techguy10k/educational-board/40-主控板/主控板背面.jpg

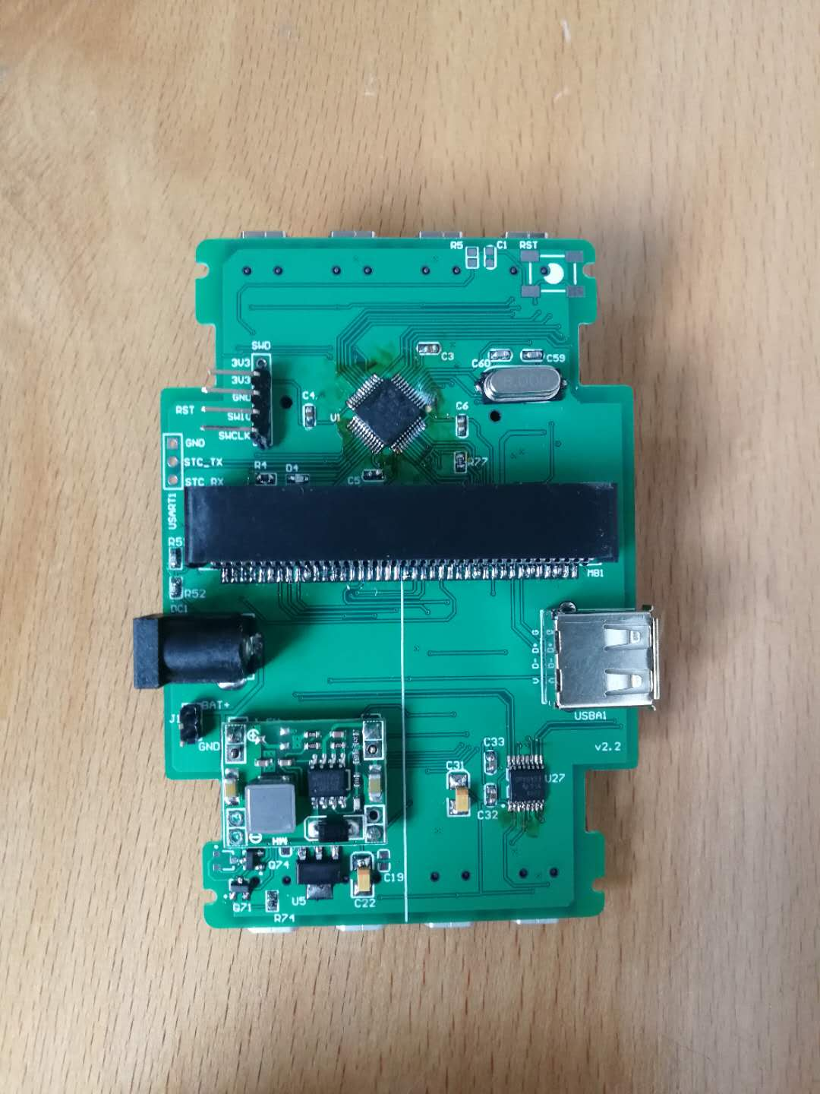
40-主控板/主控板背面.jpg
