techguy10k/educational-board/40-主控板/主控板正面.jpg

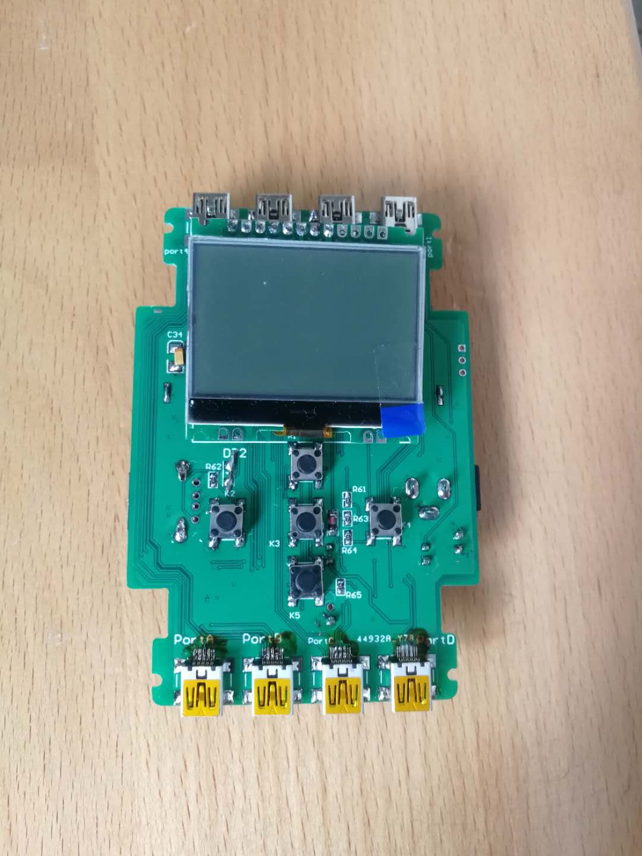
40-主控板/主控板正面.jpg
