techguy10k/educational-board/30-电机/电机参数图纸.docx

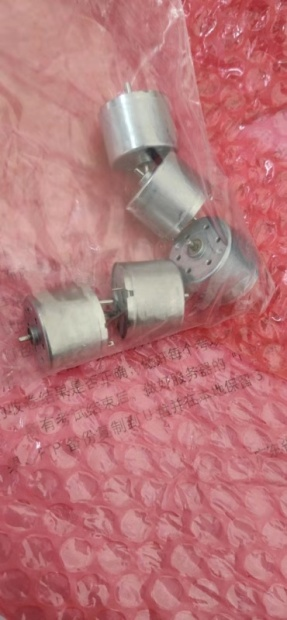
[picture p9: figure]

东莞富泰电机厂，

联系人：叶工， 电话：13532329905

需提前5天联系定制。

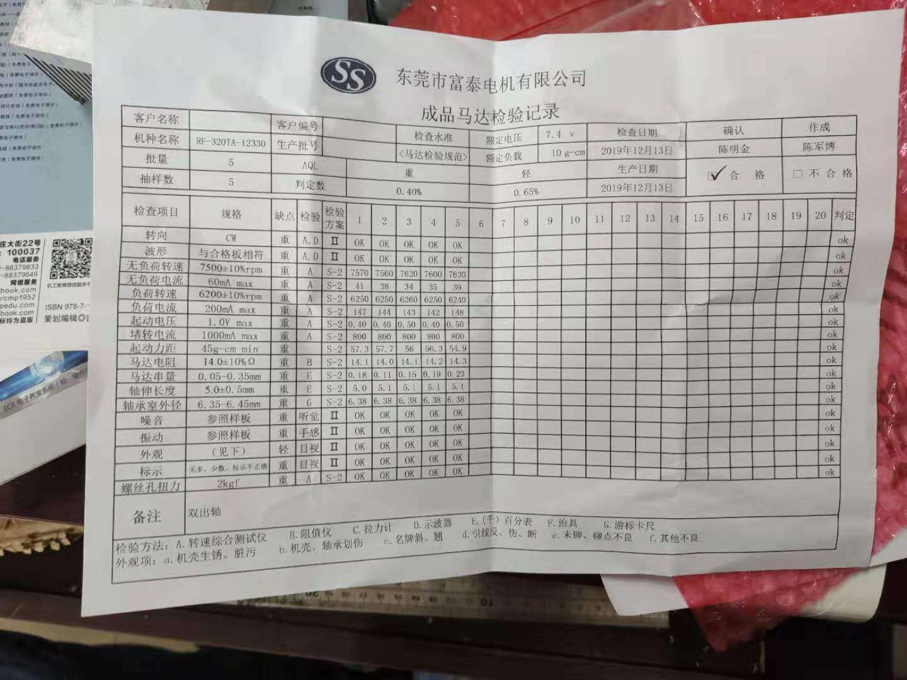
[picture p10: figure]
