techguy10k/educational-board/31-电机小板（霍尔编码器）/电机小板上的元件说明.docx

采购来源：

元件名称 | 数量 | 图片 | 网址

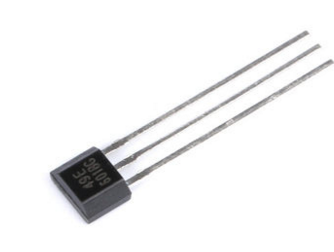
[picture p11: figure]

磁性传感器 41F | 2 | | yourcee旗舰店 (https://yourcee.tmall.com/) https://detail.tmall.com/item.htm?id=605320954363&spm=a1z09.2.0.0.72bd2e8dwAtcl9&_u=u3qeroq8b1d

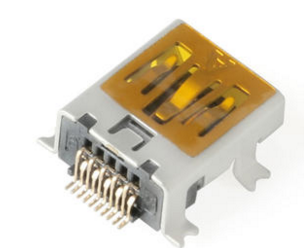
[picture p12: figure]

MiniUSB10P USB座 | 1 | | yourcee旗舰店 (https://yourcee.tmall.com/) https://detail.tmall.com/item.htm?id=599755569766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
订制的6芯USB软线 | 1 | | 需要与深圳一个线路厂联系订制

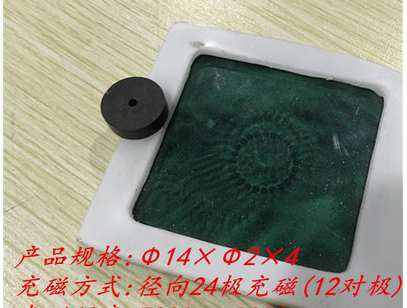
[picture p13: figure]

板外的元件一： 环形磁铁 | 1 | | 昊昶磁业 (https://suluke-magnet.taobao.com/) 网店 https://item.taobao.com/item.htm?spm=a1z09.2.0.0.72bd2e8dwAtcl9&id=542413343222&_u=u3qeroq0bea
板外的元件二： 小直流电机 | 1 | | 东莞富泰电机厂，需提前5天联系定制。

电机参数图：

见下页：
