techguy10k/educational-board/40-主控板/主控板上元件说明.docx

采购来源：

元件名称 | 数量 | 图片 | 网址

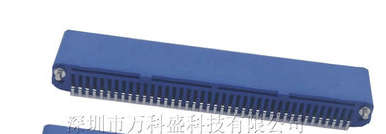
[picture p14: figure]

microbit卧式槽 | 1 | | (https://yourcee.tmall.com/)万科盛科技 (https://shop116882086.taobao.com/) 店 https://item.taobao.com/item.htm?spm=a1z09.2.0.0.626e2e8dIi6Jch&id=601872592752&_u=u3qeroqe064


MiniUSB10P USB座 （接4路电机） | 4 | | yourcee旗舰店 (https://yourcee.tmall.com/) https://detail.tmall.com/item.htm?id=599755569766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
订制的6芯USB软线 （接4路电机） | 4 | | 需要与深圳一个线路厂联系订制（蔡老师有联系方式）

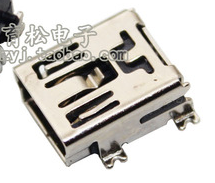
[picture p15: figure]

MINI USB 母座 插座 5P （接4路传感器模块） | 4 | | 育松电子经营部 (https://dzyj.taobao.com/)网店 https://item.taobao.com/item.htm?spm=a1z09.2.0.0.626e2e8dIi6Jch&id=1927829853&_u=u3qeroqed5f

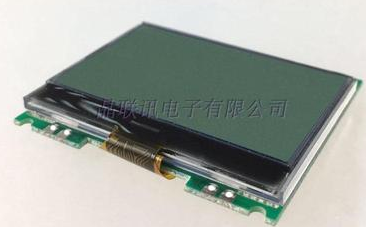
[picture p16: figure]

LCD屏 型号：12864G-086-PC | 1 | | 晶联讯电子 (https://jlxlcd.taobao.com/) https://item.taobao.com/item.htm?spm=a1z09.2.0.0.626e2e8dIi6Jch&id=12879087349&_u=u3qeroq2545

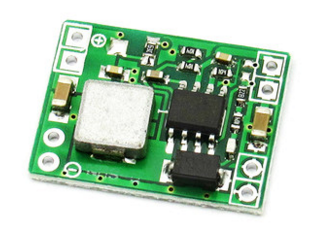
[picture p17: figure]

电源降压模块 （把锂电池电压降到5V，给板子供电） | 1 | | risym旗舰店 (https://risym.tmall.com/) https://detail.tmall.com/item.htm?id=17616429123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
