techguy10k/educational-board/01-超声波传感器模块/超声波传感器-尺寸结构.png

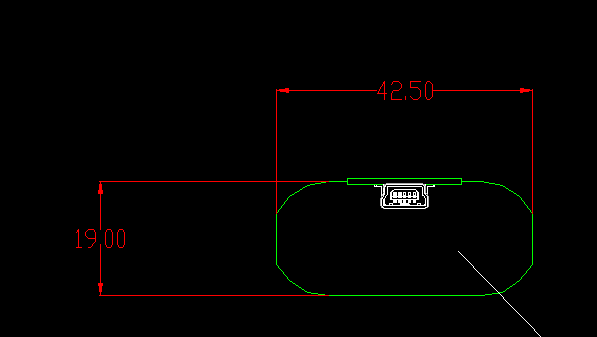
01-超声波传感器模块/超声波传感器-尺寸结构.png
