techguy10k/educational-board/02-碰撞模块/方形的传感器模块的尺寸结构.png

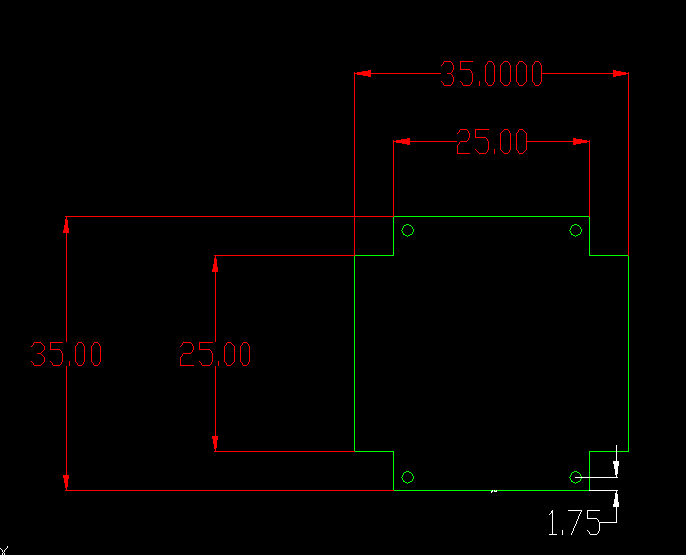
02-碰撞模块/方形的传感器模块的尺寸结构.png
