techguy10k/educational-board/12个传感器模块的列表.bmp

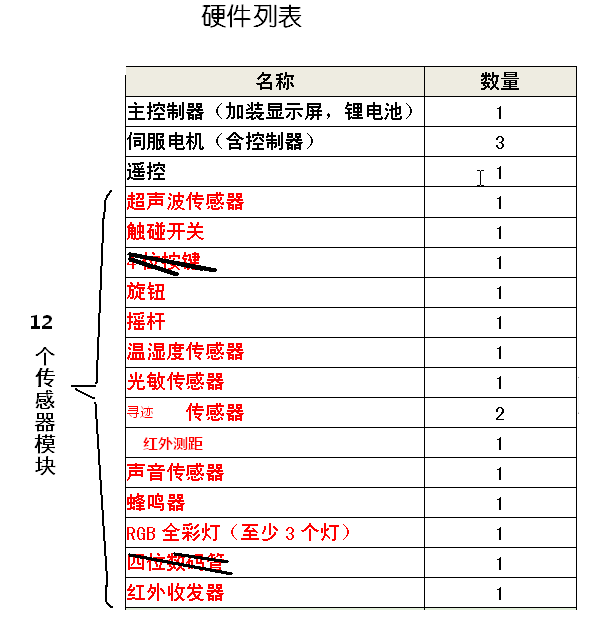
12个传感器模块的列表.bmp
