techguy10k/educational-board/01-超声波传感器模块/01-超声波传感器模块-尺寸结构图.dxf

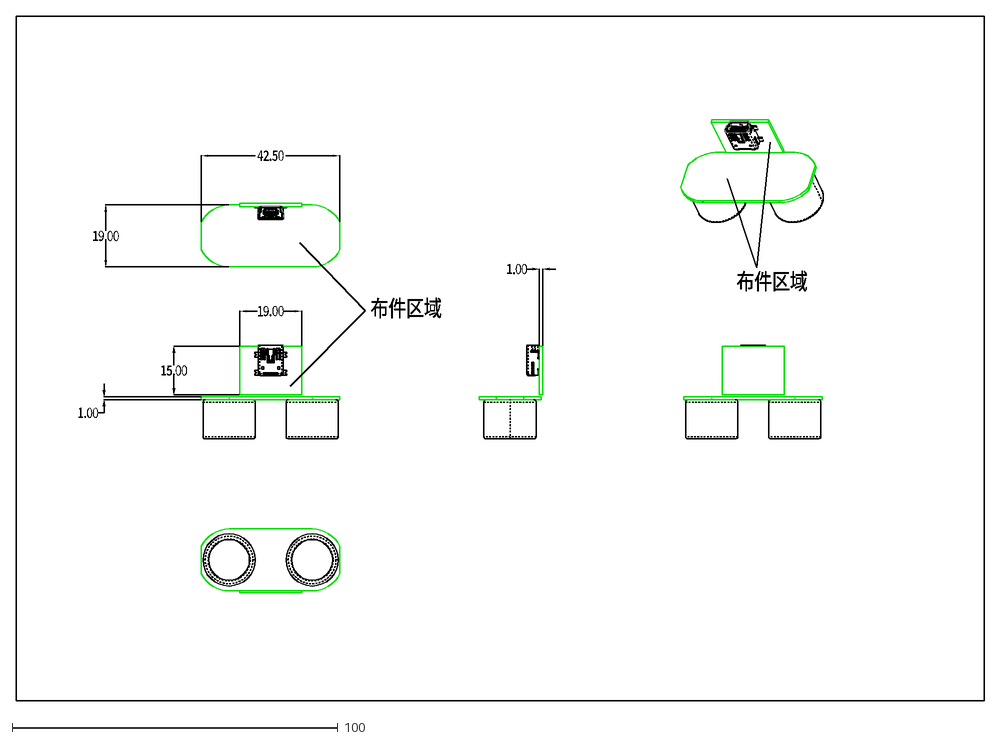
[picture p21: CAD file, 2020-11-19]
01-超声波传感器模块/01-超声波传感器模块-尺寸结构图.dxf
42.50
1.00
19.00
15.00
布件区域
