techguy10k/educational-board/02-碰撞模块/方形的传感器模块的尺寸结构图.dxf

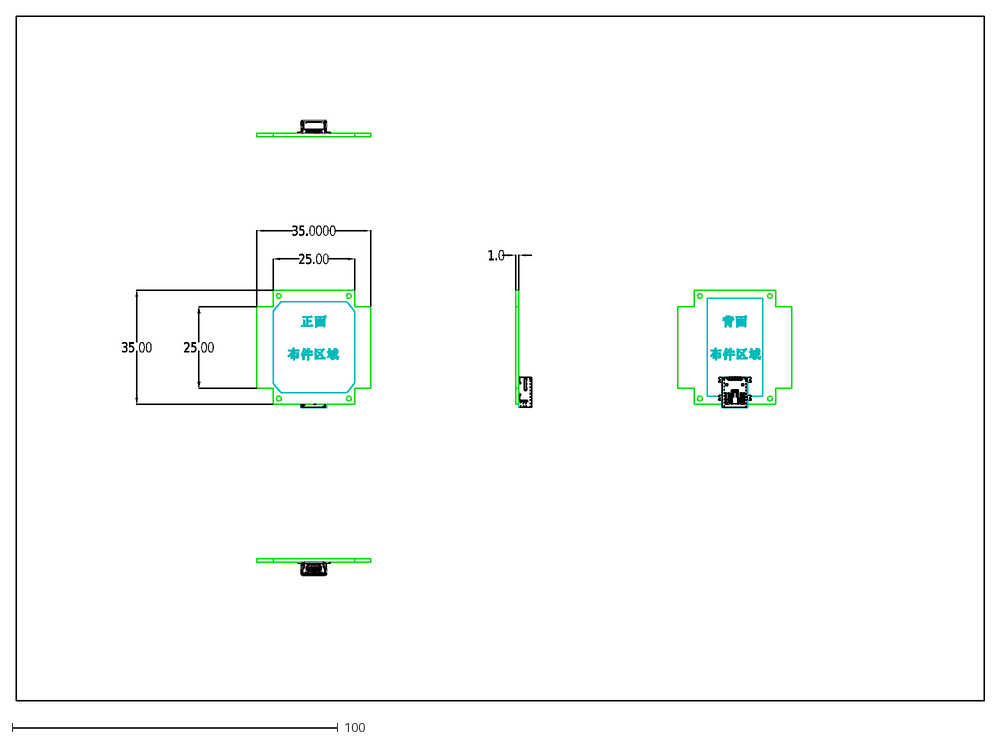
[picture p22: CAD file, 2020-11-19]
02-碰撞模块/方形的传感器模块的尺寸结构图.dxf
35.0000
25.00
35.00
1.0
