techguy10k/educational-board/31-电机小板（霍尔编码器）/电机小板的尺寸结构图.dxf

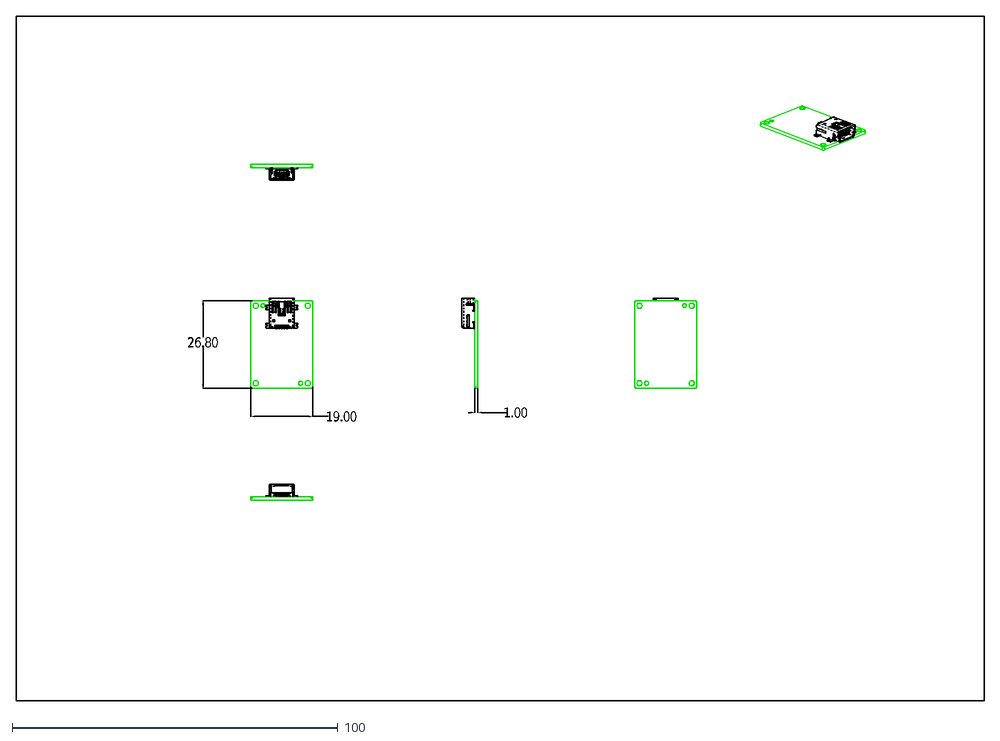
[picture p23: CAD file, 2020-11-19]
31-电机小板（霍尔编码器）/电机小板的尺寸结构图.dxf
26.80
19.00
1.00
