techguy10k/educational-board/(list of files, drawings)

Other design files:
01-超声波传感器模块/01-超声波传感器模块-原理图.SchDoc
01-超声波传感器模块/01-超声波传感器模块-电路板图.PcbDoc
02-碰撞模块/02-碰撞模块-原理图.SchDoc
02-碰撞模块/02-碰撞模块-电路板图.PcbDoc
03-旋钮模块/03-旋钮模块-原理图.SchDoc
04-摇杆模块/04-摇杆模块--原理图.SchDoc
05-温湿度传感器模块/05-温湿度传感器模块-原理图.SchDoc
05-温湿度传感器模块/05-温湿度传感器模块-电路板图.PcbDoc
06-光敏传感器模块/06-光敏传感器模块-原理图.SchDoc
06-光敏传感器模块/06-光敏传感器模块-电路板图.PcbDoc
07-寻迹传感器模块/07-寻迹传感器模块--原理图.SchDoc
08-声音传感器模块/08-声音传感器模块-原理图.SchDoc
08-声音传感器模块/08-声音传感器模块-电路板图.PcbDoc
09-蜂鸣器模块/09-蜂鸣器模块-原理图.SchDoc
10-RGB彩灯模块/10-RGB模块原理图.SchDoc
11-红外遥控接收器模块/11-红外遥控接收器模块--原理图.SchDoc
12-红外测距传感器模块/12-红外测距及避障原理图.SchDoc
31-电机小板（霍尔编码器）/电机小板的电路图.PcbDoc
31-电机小板（霍尔编码器）/电机小板（霍尔编码器）的原理图.SchDoc
40-主控板/40-主控板-电路图.PcbDoc
40-主控板/40-主控板的原理图.SchDoc
