techguy10k/educational-board/50-软件资料主控板/Project/HARDWARE/LCD12864/12864.c

#include "12864.h"
#include "sys.h"
#include "delay.h"

unsigned char biaoti[]={" HicBit "};

//用“zimo221.exe”取模出来的汉字的16进制码：
unsigned char zhuang1[]={
/*--  文字:  状  --*/
/*--  宋体12;  此字体下对应的点阵为：宽x高=16x16   --*/
0x08,0x30,0x00,0xFF,0x20,0x20,0x20,0x20,0xFF,0x20,0xE1,0x26,0x2C,0x20,0x20,0x00,
0x04,0x02,0x01,0xFF,0x40,0x20,0x18,0x07,0x00,0x00,0x03,0x0C,0x30,0x60,0x20,0x00};
 
unsigned char tai1[]={
/*--  文字:  态  --*/
/*--  宋体12;  此字体下对应的点阵为：宽x高=16x16   --*/
0x00,0x04,0x04,0x04,0x84,0x44,0x34,0x4F,0x94,0x24,0x44,0x84,0x84,0x04,0x00,0x00,
0x00,0x60,0x39,0x01,0x00,0x3C,0x40,0x42,0x4C,0x40,0x40,0x70,0x04,0x09,0x31,0x00};
 
unsigned char shi1[]={
/*--  文字:  使  --*/
/*--  宋体12;  此字体下对应的点阵为：宽x高=16x16   --*/
0x40,0x20,0xF0,0x1C,0x07,0xF2,0x94,0x94,0x94,0xFF,0x94,0x94,0x94,0xF4,0x04,0x00,
0x00,0x00,0x7F,0x00,0x40,0x41,0x22,0x14,0x0C,0x13,0x10,0x30,0x20,0x61,0x20,0x00};
 
unsigned char yong1[]={
/*--  文字:  用  --*/
/*--  宋体12;  此字体下对应的点阵为：宽x高=16x16   --*/
0x00,0x00,0x00,0xFE,0x22,0x22,0x22,0x22,0xFE,0x22,0x22,0x22,0x22,0xFE,0x00,0x00,
0x80,0x40,0x30,0x0F,0x02,0x02,0x02,0x02,0xFF,0x02,0x02,0x42,0x82,0x7F,0x00,0x00};
 
unsigned char dianchi1[]={
/*--  电池图标  --*/
/*--  宽度x高度=16x16  --*/
0x00,0x00,0x00,0x00,0x00,0x38,0x7C,0x44,0x7C,0x44,0x7C,0x44,0x7C,0x44,0x7C,0x00,
0x00,0x00,0x00,0x00,0x00,0x00,0x00,0x00,0x00,0x00,0x00,0x00,0x00,0x00,0x00,0x00};

unsigned char dianchi[]={
/*--  电池图标  --*/
/*--  宽度x高度=16x16  --*/
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
	
	GPIO_InitStructure.GPIO_Pin = cs_gpio|reset_gpio;				
	GPIO_InitStructure.GPIO_Mode = GPIO_Mode_Out_PP; 		 //推挽输出
	GPIO_InitStructure.GPIO_Speed = GPIO_Speed_50MHz;		 //IO口速度为50MHz
	GPIO_Init(GPIOA, &GPIO_InitStructure);					 //根据设定参数初始化GPIOA

}

//void main(void)
//{
//	int i;
//	UART_Init();
//	initial_lcd();
//	clear_screen();                        //clear all dots       
//	disp_blink_16x16(1,1,0,0,zhuang1);     //显示单个汉字"状". 括号里的参数分别是（页，列，闪烁与否，反显与否，数据指针）
//	disp_blink_16x16(1,17,0,0,tai1);        //显示单个汉字"态",不闪烁，反显
//	disp_blink_16x16(1,33,0,0,shi1);        //显示单个汉字"使",闪烁，不反显
//	disp_blink_16x16(1,49,0,0,yong1);       //显示单个汉字"用",闪烁，反显（当有闪烁时，反显不起作用）
//	disp_blink_16x16(1,113,0,0,dianchi);
//	LCD12864_P8x16Str(7,1,"123456789");
//	LCD12864_P6x8Str(6,1,"123456789");
//    while(1)
//    {
//		Uart_Send_String("Hello world!\r\n");
//		for(i=1;i<72;i++){
//			LCD12864_P6x8Str(6,i,"123456789");
//			delay_ms(100);
//		}
//		Uart_Send_String("www.ppptalk.com!!!\r\n");
//		Uart_Send_String("欢迎访问叁议电子!!!\r\n");
//    }
//}

 
/*写指令到LCD模块*/
void transfer_command(int data1)  
{
    char i;
    cs1=0;
    rs=0;
    for(i=0;i<8;i++)
    {
        sclk=0;
        if(data1&0x80) sid=1;
        else sid=0;
        sclk=1;
        data1<<=1;
    }
    cs1=1;
}
 
/*写数据到LCD模块*/
void transfer_data(int data1)
{
    char i;
    cs1=0;
    rs=1;
    for(i=0;i<8;i++)
    {
        sclk=0;
        if(data1&0x80) sid=1;
        else sid=0;
        sclk=1;
        data1<<=1;
    }
    cs1=1;
}
 
 
/*LCD模块初始化*/
void initial_lcd(void)
{
	LCD12864_Init();
    cs1=0;
    reset=0;        /*低电平复位*/	
    delay_us(500);
    reset=1;            /*复位完毕*/
    delay_us(200);       
    transfer_command(0xe2);  /*软复位*/
    delay_us(50);
    transfer_command(0x2c);  /*升压步聚1*/
    delay_us(50); 
    transfer_command(0x2e);  /*升压步聚2*/
    delay_us(50);
    transfer_command(0x2f);  /*升压步聚3*/
    delay_us(50);
    transfer_command(0x23);  /*粗调对比度，可设置范围0x20～0x27*/
    transfer_command(0x81);  /*微调对比度*/
    transfer_command(0x28);  /*0x28,微调对比度的值，可设置范围0x00～0x3f*/
    transfer_command(0xa2);  /*1/9偏压比（bias）*/
    transfer_command(0xc8);  /*行扫描顺序：从上到下*/
    transfer_command(0xa0);  /*列扫描顺序：从左到右*/
    transfer_command(0x40);  /*起始行：第一行开始*/
    transfer_command(0xaf);  /*开显示*/
}
 
 
void lcd_address(unsigned char page,unsigned char column)
{
    column=column-1;                            //我们平常所说的第1列，在LCD驱动IC里是第0列。所以在这里减去1.
    page=page-1;
    transfer_command(0xb0+page);            //设置页地址。每页是8行。一个画面的64行被分成8个页。我们平常所说的第1页，在LCD驱动IC里是第0页，所以在这里减去1*/
    transfer_command(((column>>4)&0x0f)+0x10);    //设置列地址的高4位
    transfer_command(column&0x0f);              //设置列地址的低4位
}
 
/*全屏清屏*/
void clear_screen(void)
{
    unsigned char i,j;
    for(i=0;i<9;i++)
    {
        lcd_address(1+i,1);
        for(j=0;j<132;j++)
        {
            transfer_data(0x00);
        }
    }
}
 
 
 
 
//显示16x16点阵图像、汉字。
//括号里的参数分别是（页，列，闪烁与否，反显与否，数据指针）
void disp_blink_16x16(unsigned char page,unsigned char column,unsigned char blink,unsigned char reverse,unsigned char *dp)
{
    unsigned char i,j,k,*data_temp;
    if(blink==0)
    {
        data_temp=dp;
        for(j=0;j<2;j++)
        {
            lcd_address(page+j,column);
            for (i=0;i<16;i++)
            {  
                if(reverse==1)
                {
                    transfer_data(~*data_temp); /*写数据到LCD,每写完一个8位的数据后列地址自动加1*/
                }
                else
                {
                    transfer_data(*data_temp);      /*写数据到LCD,每写完一个8位的数据后列地址自动加1*/
                }
                data_temp++;
            }
        }
    }
 
    else
    {
        for(k=0;k<10;k++)
        {
            data_temp=dp;
            for(j=0;j<2;j++)
            {
                lcd_address(page+j,column);
                for (i=0;i<16;i++)
                {  
                    transfer_data(~*data_temp);     /*写数据到LCD,每写完一个8位的数据后列地址自动加1*/
                    data_temp++;
                }
            }
            delay_ms(2000);
            data_temp=dp;
            for(j=0;j<2;j++)
            {
                lcd_address(page+j,column);
                for (i=0;i<16;i++)
                {  
                    transfer_data(*data_temp);      /*写数据到LCD,每写完一个8位的数据后列地址自动加1*/
                    data_temp++;
                }
            }
            delay_ms(2000);
 
        }
    }
}
 
//显示16x16点阵图像、汉字。
//括号里的参数分别是（页，列，带下划线闪烁与否，反显与否，数据指针）
void disp_underline_16x16(unsigned char page,unsigned char column,unsigned char under,unsigned char reverse,unsigned char *dp)
{
    unsigned char i,j,k,*data_temp,data1;
    if(under==0)
    {
        data_temp=dp;
        for(j=0;j<2;j++)
        {
            lcd_address(page+j,column);
            for (i=0;i<16;i++)
            {  
                if(reverse==1)
                {
                    transfer_data(~*data_temp); /*写数据到LCD,每写完一个8位的数据后列地址自动加1*/
                }
                else
                {
                    transfer_data(*data_temp);      /*写数据到LCD,每写完一个8位的数据后列地址自动加1*/
                }
                data_temp++;
            }
        }
    }
 
    else
    {
        for(k=0;k<10;k++)
        {
            data_temp=dp;
     
            lcd_address(page,column);
            for (i=0;i<16;i++)
            {  
                transfer_data(*data_temp);      /*写数据到LCD,每写完一个8位的数据后列地址自动加1*/
                data_temp++;
            }
            lcd_address(page+1,column);
            for (i=0;i<16;i++)
            {  
                data1=*data_temp|0x80;
                transfer_data(data1);       /*写数据到LCD,每写完一个8位的数据后列地址自动加1*/
                data_temp++;
            }
            delay_ms(2000);
 
 
            data_temp=dp;
            for(j=0;j<2;j++)
            {
                lcd_address(page+j,column);
                for (i=0;i<16;i++)
                {  
                    transfer_data(*data_temp);      /*写数据到LCD,每写完一个8位的数据后列地址自动加1*/
                    data_temp++;
                }
            }
            delay_ms(2000);
 
        }
    }
}
//显示16x16点阵图像、汉字。
//括号里的参数分别是（页，列，带右竖线光标闪烁与否，反显与否，数据指针）
void disp_cursor_16x16(unsigned char page,unsigned char column,unsigned char cursor,unsigned char reverse,unsigned char *dp)
{
    unsigned char i,j,k,*data_temp;
    if(cursor==0)
    {
        data_temp=dp;
        for(j=0;j<2;j++)
        {
            lcd_address(page+j,column);
            for (i=0;i<16;i++)
            {  
                if(reverse==1)
                {
                    transfer_data(~*data_temp); /*写数据到LCD,每写完一个8位的数据后列地址自动加1*/
                }
                else
                {
                    transfer_data(*data_temp);      /*写数据到LCD,每写完一个8位的数据后列地址自动加1*/
                }
                data_temp++;
            }
        }
    }
 
    else
    {
        for(k=0;k<10;k++)
        {
            data_temp=dp;
     
            lcd_address(page,column);
            for (i=0;i<15;i++)
            {  
                transfer_data(*data_temp);      /*写数据到LCD,每写完一个8位的数据后列地址自动加1*/
                data_temp++;
            }
            transfer_data(0xff);
            data_temp++;
            lcd_address(page+1,column);
            for (i=0;i<15;i++)
            {  
                transfer_data(*data_temp);      /*写数据到LCD,每写完一个8位的数据后列地址自动加1*/
                data_temp++;
            }
            transfer_data(0xff);
            data_temp++;
            delay_ms(2000);
 
 
            data_temp=dp;
            for(j=0;j<2;j++)
            {
                lcd_address(page+j,column);
                for (i=0;i<16;i++)
                {  
                    transfer_data(*data_temp);      /*写数据到LCD,每写完一个8位的数据后列地址自动加1*/
                    data_temp++;
                }
            }
            delay_ms(2000);
 
        }
    }
}

void LCD12864_P6x8Str(unsigned char y,unsigned char x,unsigned char ch[])
{
	unsigned char c=0,i=0,j=0;
	while (ch[j]!='\0')
	{
		c =ch[j]-32;
		if(x>126){x=0;y++;}
		lcd_address(y,x);
		for(i=0;i<6;i++)
			transfer_data(F6x8[c][i]);
		x+=6;
		j++;
	}
}

void LCD12864_P8x16Str(unsigned char y,unsigned char x,unsigned char ch[])
{
	unsigned char c=0,i=0,j=0;
	while (ch[j]!='\0')
	{
		c =ch[j]-32;
		if(x>120){x=0;y++;}
		lcd_address(y,x);
		for (i=0;i<8;i++)
			transfer_data(F8X16[c*16+i]); /*写数据到LCD,每写完一个8位的数据后列地址自动加1*/
		lcd_address(y+1,x);
		for(i=0;i<8;i++)
			transfer_data(F8X16[c*16+i+8]);
		x+=8;
		j++;
	}
}

//显示16x16点阵图像、汉字。
//括号里的参数分别是（页，列，闪烁与否，反显与否，数据指针）
void disp_blink_40x40(unsigned char page,unsigned char column,unsigned char blink,unsigned char reverse,unsigned char *dp)
{
    unsigned char i,j,k,*data_temp;
    if(blink==0)
    {
        data_temp=dp;
        for(j=0;j<1;j++)
        {
            lcd_address(page+j,column);
            for (i=0;i<40;i++)
            {  
                if(reverse==1)
                {
                    transfer_data(~*data_temp); /*写数据到LCD,每写完一个8位的数据后列地址自动加1*/
                }
                else
                {
                    transfer_data(*data_temp);      /*写数据到LCD,每写完一个8位的数据后列地址自动加1*/
                }
                data_temp++;
            }
        }
    }
 
    else
    {
        for(k=0;k<10;k++)
        {
            data_temp=dp;
            for(j=0;j<2;j++)
            {
                lcd_address(page+j,column);
                for (i=0;i<40;i++)
                {  
                    transfer_data(~*data_temp);     /*写数据到LCD,每写完一个8位的数据后列地址自动加1*/
                    data_temp++;
                }
            }
            delay_ms(2000);
            data_temp=dp;
            for(j=0;j<2;j++)
            {
                lcd_address(page+j,column);
                for (i=0;i<40;i++)
                {  
                    transfer_data(*data_temp);      /*写数据到LCD,每写完一个8位的数据后列地址自动加1*/
                    data_temp++;
                }
            }
            delay_ms(2000);
 
        }
    }
}
