techguy10k/educational-board/50-软件资料主控板/Project/HARDWARE/ENCODER/encoder.h

#ifndef __ENCODER_H
#define __ENCODER_H
#include <sys.h>	 

#define ENCODER_TIM_PERIOD (u16)(65535)   //不可大于65535 因为F103的定时器是16位的。
void Encoder_Init_TIM2(void);
void Encoder_Init_TIM4(void);
int Read_Encoder(u8 TIMX);
void TIM4_IRQHandler(void);
void TIM2_IRQHandler(void);

int Read_Position(u8 TIMX);
#endif
