techguy10k/educational-board/50-软件资料主控板/Project/HARDWARE/EXTI/exti.c

#include "exti.h"
#include "led.h"
#include "key.h"
#include "delay.h"
#include "usart.h"
#include "12864.h"
 
//外部中断初始化函数
void EXTIX_Init(void)
{
 
 	  EXTI_InitTypeDef EXTI_InitStructure;
 	  NVIC_InitTypeDef NVIC_InitStructure;

  	RCC_APB2PeriphClockCmd(RCC_APB2Periph_AFIO,ENABLE);//外部中断，需要使能AFIO时钟

	  KEY_Init();//初始化按键对应io模式

    //GPIOA.15 中断线以及中断初始化配置
  	GPIO_EXTILineConfig(GPIO_PortSourceGPIOA,GPIO_PinSource15);

  	EXTI_InitStructure.EXTI_Line=EXTI_Line15;
  	EXTI_InitStructure.EXTI_Mode = EXTI_Mode_Interrupt;	
  	EXTI_InitStructure.EXTI_Trigger = EXTI_Trigger_Falling;//下降沿触发
  	EXTI_InitStructure.EXTI_LineCmd = ENABLE;
  	EXTI_Init(&EXTI_InitStructure);	 	//根据EXTI_InitStruct中指定的参数初始化外设EXTI寄存器
	
	//GPIOB.0	  中断线以及中断初始化配置
  	GPIO_EXTILineConfig(GPIO_PortSourceGPIOB,GPIO_PinSource0);

   	EXTI_InitStructure.EXTI_Line=EXTI_Line0;
  	EXTI_InitStructure.EXTI_Mode = EXTI_Mode_Interrupt;	
  	EXTI_InitStructure.EXTI_Trigger = EXTI_Trigger_Falling;
  	EXTI_InitStructure.EXTI_LineCmd = ENABLE;
  	EXTI_Init(&EXTI_InitStructure);		//根据EXTI_InitStruct中指定的参数初始化外设EXTI寄存器
	
	//GPIOB.1	  中断线以及中断初始化配置
  	GPIO_EXTILineConfig(GPIO_PortSourceGPIOB,GPIO_PinSource1);

   	EXTI_InitStructure.EXTI_Line=EXTI_Line1;
  	EXTI_InitStructure.EXTI_Mode = EXTI_Mode_Interrupt;	
  	EXTI_InitStructure.EXTI_Trigger = EXTI_Trigger_Falling;
  	EXTI_InitStructure.EXTI_LineCmd = ENABLE;
  	EXTI_Init(&EXTI_InitStructure);		//根据EXTI_InitStruct中指定的参数初始化外设EXTI寄存器


    //GPIOB.4	  中断线以及中断初始化配置
  	GPIO_EXTILineConfig(GPIO_PortSourceGPIOB,GPIO_PinSource4);

  	EXTI_InitStructure.EXTI_Line=EXTI_Line4;
  	EXTI_InitStructure.EXTI_Mode = EXTI_Mode_Interrupt;	
  	EXTI_InitStructure.EXTI_Trigger = EXTI_Trigger_Falling;
  	EXTI_InitStructure.EXTI_LineCmd = ENABLE;
  	EXTI_Init(&EXTI_InitStructure);	  	//根据EXTI_InitStruct中指定的参数初始化外设EXTI寄存器

    
	//GPIOB.5	  中断线以及中断初始化配置
  	GPIO_EXTILineConfig(GPIO_PortSourceGPIOB,GPIO_PinSource5);

   	EXTI_InitStructure.EXTI_Line=EXTI_Line5;
  	EXTI_InitStructure.EXTI_Mode = EXTI_Mode_Interrupt;	
  	EXTI_InitStructure.EXTI_Trigger = EXTI_Trigger_Falling;
  	EXTI_InitStructure.EXTI_LineCmd = ENABLE;
  	EXTI_Init(&EXTI_InitStructure);		//根据EXTI_InitStruct中指定的参数初始化外设EXTI寄存器

 
  	NVIC_InitStructure.NVIC_IRQChannel = EXTI15_10_IRQn;			//使能按键所在的外部中断通道
  	NVIC_InitStructure.NVIC_IRQChannelPreemptionPriority = 0x02;	//抢占优先级2 
  	NVIC_InitStructure.NVIC_IRQChannelSubPriority = 0x01;					//子优先级1
  	NVIC_InitStructure.NVIC_IRQChannelCmd = ENABLE;								//使能外部中断通道
  	NVIC_Init(&NVIC_InitStructure);  	  //根据NVIC_InitStruct中指定的参数初始化外设NVIC寄存器
	
	NVIC_InitStructure.NVIC_IRQChannel = EXTI0_IRQn;			//使能按键所在的外部中断通道
  	NVIC_InitStructure.NVIC_IRQChannelPreemptionPriority = 0x02;	//抢占优先级2， 
  	NVIC_InitStructure.NVIC_IRQChannelSubPriority = 0x01;					//子优先级1
  	NVIC_InitStructure.NVIC_IRQChannelCmd = ENABLE;								//使能外部中断通道
  	NVIC_Init(&NVIC_InitStructure); 
	
	NVIC_InitStructure.NVIC_IRQChannel = EXTI1_IRQn;			//使能按键所在的外部中断通道
  	NVIC_InitStructure.NVIC_IRQChannelPreemptionPriority = 0x02;	//抢占优先级2， 
  	NVIC_InitStructure.NVIC_IRQChannelSubPriority = 0x01;					//子优先级1
  	NVIC_InitStructure.NVIC_IRQChannelCmd = ENABLE;								//使能外部中断通道
  	NVIC_Init(&NVIC_InitStructure); 
		
	NVIC_InitStructure.NVIC_IRQChannel = EXTI4_IRQn;			//使能按键所在的外部中断通道
  	NVIC_InitStructure.NVIC_IRQChannelPreemptionPriority = 0x02;	//抢占优先级2， 
  	NVIC_InitStructure.NVIC_IRQChannelSubPriority = 0x01;					//子优先级1
  	NVIC_InitStructure.NVIC_IRQChannelCmd = ENABLE;								//使能外部中断通道
  	NVIC_Init(&NVIC_InitStructure); 
 
 
   	NVIC_InitStructure.NVIC_IRQChannel = EXTI9_5_IRQn;			//使能按键所在的外部中断通道
  	NVIC_InitStructure.NVIC_IRQChannelPreemptionPriority = 0x02;	//抢占优先级2， 
  	NVIC_InitStructure.NVIC_IRQChannelSubPriority = 0x01;					//子优先级1
  	NVIC_InitStructure.NVIC_IRQChannelCmd = ENABLE;								//使能外部中断通道
  	NVIC_Init(&NVIC_InitStructure); 
 
}

/**************************************************************************
函数功能：定时器中断初始化
入口参数：arr 设定计数器自动重装值
					psc 预分频器7200,得到10Khz的计数时钟
返回  值：无 
**************************************************************************/
void Timer1_Init(u16 arr,u16 psc)  
{  
	TIM_TimeBaseInitTypeDef  TIM_TimeBaseStructure;
	NVIC_InitTypeDef NVIC_InitStructure;

	RCC_APB2PeriphClockCmd(RCC_APB2Periph_TIM1, ENABLE); //时钟使能

	TIM_TimeBaseStructure.TIM_Period = arr; //设置在下一个更新事件装入活动的自动重装载寄存器周期的值	 计数到5000为500ms
	TIM_TimeBaseStructure.TIM_Prescaler =psc; //设置用来作为TIMx时钟频率除数的预分频值  10Khz的计数频率  
	TIM_TimeBaseStructure.TIM_ClockDivision = 0; //设置时钟分割:TDTS = Tck_tim
	TIM_TimeBaseStructure.TIM_CounterMode = TIM_CounterMode_Up;  //TIM向上计数模式
	TIM_TimeBaseInit(TIM1, &TIM_TimeBaseStructure); //根据TIM_TimeBaseInitStruct中指定的参数初始化TIMx的时间基数单位
 
	TIM_ITConfig(  //使能或者失能指定的TIM中断
		TIM1, //TIM1
		TIM_IT_Update ,
		ENABLE  //使能
		);
	NVIC_InitStructure.NVIC_IRQChannel = TIM1_UP_IRQn;  //TIM3中断
	NVIC_InitStructure.NVIC_IRQChannelPreemptionPriority = 1;  //先占优先级1级
	NVIC_InitStructure.NVIC_IRQChannelSubPriority = 3;  //从优先级3级
	NVIC_InitStructure.NVIC_IRQChannelCmd = ENABLE; //IRQ通道被使能
	NVIC_Init(&NVIC_InitStructure);  //根据NVIC_InitStruct中指定的参数初始化外设NVIC寄存器

	TIM_Cmd(TIM1, ENABLE);  //使能TIMx外设
} 


//void EXTI15_10_IRQHandler(void){
//	delay_ms(10);    //消抖
//	if(KEY0==0){					//按键左	  
//		
//	}
//	EXTI_ClearITPendingBit(EXTI_Line15);
//}
// 
//void EXTI4_IRQHandler(void)
//{
//  delay_ms(10);    //消抖
//	if(KEY1==0){	  
//		
//	}
//	EXTI_ClearITPendingBit(EXTI_Line4);  //清除EXTI0线路挂起位
//}
// void EXTI2_IRQHandler(void)
//{			
//	delay_ms(10);   //消抖			 
//	if(KEY2==0){
//		
//	}
// 	 EXTI_ClearITPendingBit(EXTI_Line2);    //清除LINE5上的中断标志位  
//}
