techguy10k/educational-board/50-软件资料主控板/Project/HARDWARE/KEY/key.c

#include "key.h"
#include "delay.h"

//按键初始化函数 
//PA0.15和PC5 设置成输入
void KEY_Init(void)
{
	
	GPIO_InitTypeDef GPIO_InitStructure;

 	RCC_APB2PeriphClockCmd(RCC_APB2Periph_GPIOB,ENABLE);//使能PORTA,PORTB时钟

	GPIO_PinRemapConfig(GPIO_Remap_SWJ_JTAGDisable, ENABLE);//关闭jtag，使能SWD，可以用SWD模式调试
	
	GPIO_InitStructure.GPIO_Pin  = GPIO_Pin_5;//PB5
	GPIO_InitStructure.GPIO_Mode = GPIO_Mode_IPU; //设置成上拉输入
	GPIO_Init(GPIOB, &GPIO_InitStructure);//初始化GPIOB5
	
} 


/**************************************************************************
函数功能：按键扫描
入口参数：双击等待时间
返回  值：按键状态 0：无动作 1：单击 2：双击 
**************************************************************************/
u8 click_N_Double (u8 time,u8 KEY)
{
	static	u8 flag_key,count_key,double_key;	
	static	u16 count_single,Forever_count;
	
	if(KEY==0)  
		Forever_count++;   //长按标志位未置1
	else        
		Forever_count=0;
	
	if(0==KEY&&0==flag_key)		
		flag_key=1;	
	
	if(0==count_key)
	{
		if(flag_key==1) 
		{
			double_key++;
			count_key=1;	
		}
		if(double_key==2) 
		{
			double_key=0;
			count_single=0;
			return 2;//双击执行的指令
		}
	}
	
	if(1==KEY)			
		flag_key=0,count_key=0;

	if(1==double_key)
	{
		count_single++;
		if(count_single>time&&Forever_count<time)
		{
			double_key=0;
			count_single=0;	
			return 1;//单击执行的指令
		}
		if(Forever_count>time)
		{
			double_key=0;
			count_single=0;	
		}
	}	
	return 0;
}

/**************************************************************************
函数功能：长按检测
入口参数：无
返回  值：按键状态 0：无动作 1：长按2s
**************************************************************************/
u8 Long_Press(u8 KEY)
{
	static u16 Long_Press_count,Long_Press;
	
	if(Long_Press==0&&KEY==0)  
		Long_Press_count++;   				//长按标志位未置1
	else                       
		Long_Press_count=0; 
	
	if(Long_Press_count>200)		
	{
		Long_Press=1;	
		Long_Press_count=0;
		return 1;
	}				
	
	if(Long_Press==1)     					//长按标志位置1
	{
		Long_Press=0;
	}
	
	return 0;
}
