techguy10k/educational-board/50-软件资料主控板/Project/HARDWARE/KEY/key.h

#ifndef __KEY_H
#define __KEY_H	 
#include "sys.h" 
 
#define KEY0   GPIO_ReadInputDataBit(GPIOB,GPIO_Pin_5)//读取按键中

void KEY_Init(void);//IO初始化
u8 KEY_Scan(u8 mode);  	//按键扫描函数	
u8 click_N_Double (u8 time,u8 KEY);
u8 Long_Press(u8 KEY);

#endif
