techguy10k/educational-board/50-软件资料主控板/Project/HARDWARE/LED/led.c

#include "led.h"
		    
//LED IO初始化
void LED_Init(void)
{
 GPIO_InitTypeDef  GPIO_InitStructure;
 	
 RCC_APB2PeriphClockCmd(RCC_APB2Periph_GPIOA, ENABLE);	 //使能PA,PD端口时钟
	
 GPIO_InitStructure.GPIO_Pin = GPIO_Pin_12;	    		 //LED0-->PB11 端口配置, 推挽输出
 GPIO_InitStructure.GPIO_Mode = GPIO_Mode_Out_PP; 		 //推挽输出
 GPIO_InitStructure.GPIO_Speed = GPIO_Speed_50MHz;		 //IO口速度为50MHz
 GPIO_Init(GPIOA, &GPIO_InitStructure);	  				 //推挽输出 ，IO口速度为50MHz
 GPIO_SetBits(GPIOA,GPIO_Pin_12); 						 //PB.11 输出高 
}

//IO初始化
void Power_off_button_Init(void)
{
 GPIO_InitTypeDef  GPIO_InitStructure;
 	
 RCC_APB2PeriphClockCmd(RCC_APB2Periph_GPIOA, ENABLE);	 //使能PA,PD端口时钟
	
 GPIO_InitStructure.GPIO_Pin = GPIO_Pin_3;	    		 //LED0-->PB11 端口配置, 推挽输出
 GPIO_InitStructure.GPIO_Mode = GPIO_Mode_Out_PP; 		 //推挽输出
 GPIO_InitStructure.GPIO_Speed = GPIO_Speed_50MHz;		 //IO口速度为50MHz
 GPIO_Init(GPIOA, &GPIO_InitStructure);	  				 //推挽输出 ，IO口速度为50MHz
// GPIO_SetBits(GPIOA,GPIO_Pin_3); 						 //PB.11 输出高 
}

//IO初始化
void backlight_Init(void)
{
 GPIO_InitTypeDef  GPIO_InitStructure;
 	
 RCC_APB2PeriphClockCmd(RCC_APB2Periph_GPIOA, ENABLE);	 //使能PA,PD端口时钟
	
 GPIO_InitStructure.GPIO_Pin = GPIO_Pin_15;	    		 //LED0-->PB11 端口配置, 推挽输出
 GPIO_InitStructure.GPIO_Mode = GPIO_Mode_Out_PP; 		 //推挽输出
 GPIO_InitStructure.GPIO_Speed = GPIO_Speed_50MHz;		 //IO口速度为50MHz
 GPIO_Init(GPIOA, &GPIO_InitStructure);	  				 //推挽输出 ，IO口速度为50MHz
// GPIO_SetBits(GPIOA,GPIO_Pin_3); 						 //PB.11 输出高 
}
 
